ramb0t/EMC_5uH_LISN/3dmodels/SMA_TE_5-1814832-2_Vertical.step

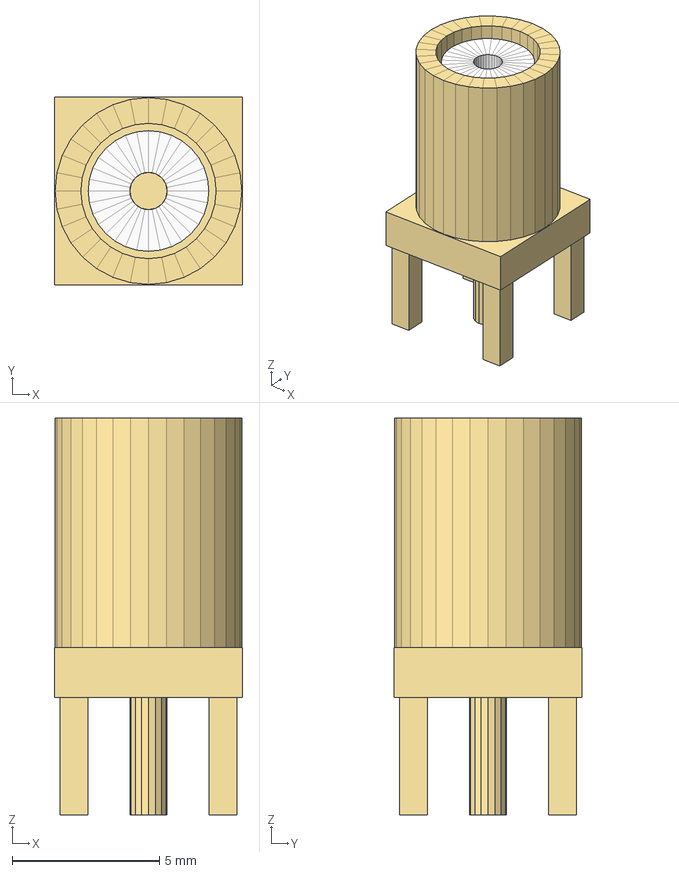
[picture p1: CAD file, 2026-11-04]
3dmodels/SMA_TE_5-1814832-2_Vertical.step
6.40 x 6.40 x 13.5 mm
