ramb0t/EMC_5uH_LISN/3dmodels/L_Coilcraft_1008PS.step

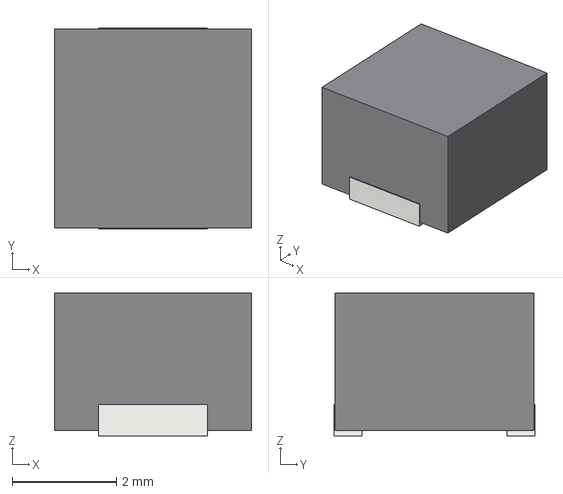
[picture p2: CAD file, 2026-11-04]
3dmodels/L_Coilcraft_1008PS.step
3.78 x 3.86 x 2.74 mm
