ramb0t/EMC_5uH_LISN/3dmodels/Banana_Keystone_575-8.step

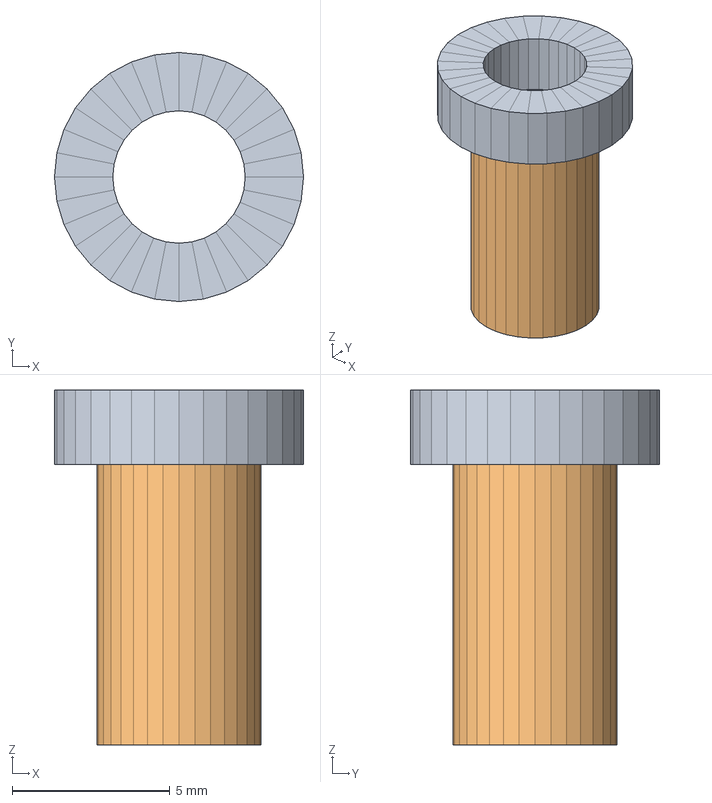
[picture p3: CAD file, 2026-11-04]
3dmodels/Banana_Keystone_575-8.step
7.90 x 7.90 x 11.3 mm
