ramb0t/EMC_5uH_LISN/3dmodels/GDT_TDK_S30-A_1812.step

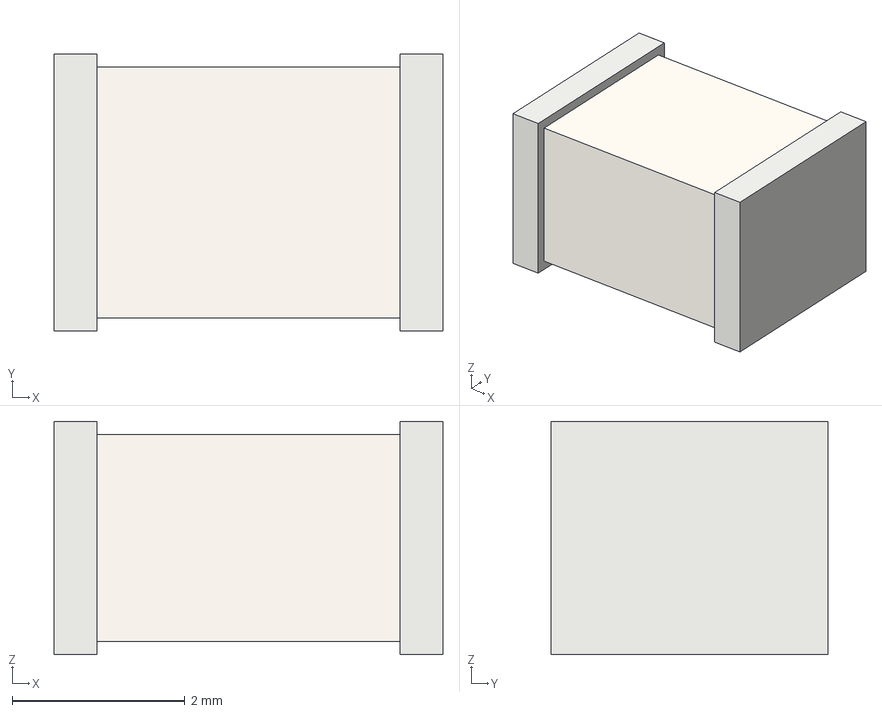
[picture p4: CAD file, 2026-11-04]
3dmodels/GDT_TDK_S30-A_1812.step
4.50 x 3.20 x 2.70 mm
