ramb0t/EMC_5uH_LISN/(commit log)

2026-11-04 Upgrade project to KiCad 10
    Saved schematic, PCB and project in KiCad 10.0.7 (no design changes).
    DRC unchanged except the six 0.4992 mm zone-clearance errors, gone after
    the zone refill on save. ERC unchanged (warnings only).
    .kicad_prl (local view state) left uncommitted; .gitignore added for
    KiCad 10 local history, lock files and backups.
    [5uH_LISN.kicad_pcb, 5uH_LISN.kicad_sch]
2026-11-04 jlcpcb: read KiCad 8+ schematic and PCB formats
    KiCad 8+ dropped the schematic symbol_instances section, indents with
    tabs and stores footprint references as property "Reference". Read
    references, values and footprints from the placed symbols instead, accept
    both indent styles and lib_name before lib_id, and treat an empty value
    as "~" as KiCad 7 did.
    Checked on the KiCad 7 files from the jlcpcb branch: same refs, values,
    footprints and placements as the old parser. On the KiCad 10 files the
    result is identical, so out/ is unchanged.
    --check now compares gerbers.zip by member contents; the zlib byte stream
    differs between Python builds and was reported stale on unchanged input.
    Co-Authore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
2026-11-04 Start V1 R1: revision label, text placement, BOM fields
    Ben's edits in KiCad 10: board revision text "V1 R0 12Dec2021" ->
    "V1 R1 112026", four texts moved, manf#/LCSC/Manufacturer/Description
    columns added to the BOM field list. The rest of the PCB diff is KiCad
    reordering track segments.
    [5uH_LISN.kicad_pcb]
2026-11-04 Add 3D models for every part
    KiCad 10 path fixes (the "2 WRL models could not be matched" warning):
    C1/C2 -> C_2220_5750Metric.step (KiCad renamed 5650 to 5750, same pads),
    D1-D4 -> Package_TO_SOT_SMD/SOT-23.step (Diodes_SMD no longer exists).
    L1-L5, L7-L11 had no model -> KiCad's L_Wuerth_HCI-7050.step.
    L6/L12 (Coilcraft 1008PS), GD1/GD2 (TDK S30-A), J3-J8 (Keystone 575-8)
    and J1/J2 (TE 5-1814832-2 SMA) get simplified models generated from
    datasheet dimensions by 3dmodels/generate_models.py. The vendor models
    are login/bot-gated or licensed without redistribution rights (Wurth,
    TE), so they can't go in this MIT repository. KiCad's footprint for the
    SMA references a Wurth STEP that kicad-pa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
    [5uH_LISN.kicad_pcb, Banana_Keystone_575-8.step, GDT_TDK_S30-A_1812.step, L_Coilcraft_1008PS.step, SMA_TE_5-1814832-2_Vertical.step]
2026-11-04 R29/R30: 560R JLC basic part instead of 562R
    C28636 (UNI-ROYAL 0805W8F5600T5E) replaces C17755. -0.4 % is inside
    the 1 % tolerance of the attenuator resistors, and the basic part
    avoids one extended-part loading fee. The other 15 extended lines have
    no basic equivalent: all basic MLCCs are 50 V (these need 100/250 V)
    and the remaining resistor values are E96.
    Value changed in schematic and PCB; DRC and parity unchanged.
    [5uH_LISN.kicad_pcb, 5uH_LISN.kicad_sch, jlc_bom.csv, parts.csv]
2026-11-04 jlcpcb: order from V1 R1 Gerbers plotted in KiCad 10
    plot_gerbers.sh plots the same layers, origin (absolute, not aux) and
    Protel names as the upstream camset into Gerber_V1R1/; generate.py now
    zips that folder, so gerbers.zip carries Ben's R1 silkscreen edits.
    Checked by rendering both sets at 0.05 mm and diffing: copper, mask,
    paste and outline differ by under 0.5 mm2 per 4 mm cell (zone refill
    and arc approximation edges); the 469 drill hits match (0.399 vs 0.4 mm
    is inch rounding); silkscreen differs only at the moved title, the two
    GND labels and the V1 R1 label. Same coordinates, so jlc_cpl.csv is
    unchanged.
    [5uH_LISN-B_Mask.gbs, 5uH_LISN-B_Paste.gbp, 5uH_LISN-B_Silkscreen.gbo, 5uH_LISN-Back.gbl, 5uH_LISN-Edge_Cuts.gm1, 5uH_LISN-F_Mask.gts, 5uH_LISN-F_Paste.gtp, 5uH_LISN-F_Silkscreen.gto]
